michaelmccamy/Notechalant/app/src/motion/README.md

# Motion

Owner is CpE 2. This folder turns raw gyro samples into cursor movement.

## The contract

`index.js` must export `createMotion(config)`, which returns an object with

- `update(sample)` takes one sample (format in `docs/data-format.md`) and returns `{ dx, dy, ready }`
  - `dx`, `dy` are how far to move the cursor, in screen pixels, for this sample
  - `ready` is `false` while calibrating, and the app ignores movement until it's `true`
- `reset()` starts over, including calibration. The app calls it when the user presses **R**.
- `config` is the live settings object, so a tuning slider can change values on the fly.

Everything else in this folder is yours. Split it into as many files as you want.

## Suggested order

1. **Bias calibration.** Average the gyro for the first 2 seconds while the pen is still, subtract that from every sample after. Return `ready: false` until it's done.
2. **Axis mapping.** `xVector` and `yVector` are the gyro directions (gx, gy, gz) that move the cursor right and down. They're vectors, not single axes, because the sensor sits at an angle in the pen, so a sideways sweep turns all three axes. The defaults were measured on the real pen. To measure again for a different grip, press **D** and run the **Axis wizard**: hold still, draw a line right, draw a line down, 2 seconds each, the way you write. **D** also shows live gyro graphs and records debug files (see `docs/data-format.md`).
3. **One Euro filter** on `dx` and `dy` (or on the gyro rates) so slow movement is smooth and fast movement stays responsive.
4. **Dead zone** so tiny hand tremor while holding still doesn't move the cursor.
5. **Tuning** on the live pen. Sensitivity and filter settings are the knobs.

## Testing without the pen

Load `data/recordings/synthetic/shapes.jsonl` in the app. It traces a circle, a square, and a check mark, with a small gyro bias and noise built in. With the placeholder you'll see the shapes drift and wobble. Once calibration and filtering work, they should come out clean.

The generator in `tools/make-synthetic.mjs` documents the exact bias and noise it adds.
