michaelmccamy/Notechalant/firmware/esp32/secrets.example.h

// Copy this file to secrets.h and fill it in. secrets.h is gitignored.

// 2.4 GHz network the laptop is also on. Leave WIFI_SSID empty for Bluetooth and USB only.
#define WIFI_SSID "your-network"
#define WIFI_PASSWORD "your-password"

// The laptop's address on that network, from the relay's startup output
// (the en0 line on a Mac). Just the IP, no ws:// and no port.
#define RELAY_HOST "192.168.1.23"
