michaelmccamy/Notechalant/(commit log)

2026-10-17 Define the pen data format and add a synthetic recording
    One JSON sample per line at about 100 Hz. The synthetic recording has known shapes so the app can be tested with no hardware.
2026-10-17 Add firmware folders for the STM32 test and ESP32 pen
    Both boards must print samples in the format from docs/data-format.md.
2026-10-17 Add the ink canvas app with a shared input hub
    USB serial, WiFi WebSocket, and recording replay all feed one onPenData function. Includes a placeholder motion module and tests for the sample parser and motion math.
2026-10-17 Add the WiFi relay and a fake pen for testing
    The ESP32 now connects as a WebSocket client to a relay on the laptop
    (port 8080) instead of hosting its own network. That keeps the laptop
    online so the recognition server can still reach Gemini. Direct WiFi
    stays documented as the fallback.
    The relay lists every IPv4 interface on startup, with en0 marked as the
    likely WiFi, since the first address can be a VPN.
2026-10-17 Add the Relay input to the app
    A Relay button connects to ws://localhost:8080/app, reconnects every
    second if the relay restarts, and shows relay and pen status with the
    live sample rate. Samples go through the existing parseSample and
    hub.onPenData, so motion processing is unchanged. Mouse input and the
    USB, WiFi and recording sources work as before.
2026-10-17 Add the ESP32 pen firmware
    Reads the MPU6050 over Wire registers at 100 Hz on a micros() schedule
    and sends each sample as one JSON line (docs/data-format.md) to the
    relay over WiFi and to USB serial as a fallback. Networking runs in its
    own task on core 0 so a slow or missing relay never stalls sampling.
    WiFi, relay host and password live in a gitignored secrets.h.
    Builds for the XIAO ESP32S3 with no warnings.
    [esp32.ino, secrets.example.h]
2026-10-17 Deploy the app and recognition to Vercel
    vercel.json builds app/ and serves api/recognize.mjs as a function. The Gemini call moved to server/recognize.mjs so the local server and the Vercel function share it. The relay still runs on the laptop.
2026-10-17 Switch recognition to Gemini Flash-Lite and retry stalled requests
    Flash took 4 to 40 seconds and the free tier allows only 5 requests per minute. Flash-Lite answered in about 1 second and read every test image correctly. Requests that stall for 8 seconds are retried once. A blank canvas now returns (nothing recognized) instead of a sentence.
2026-10-17 Open Word, Excel, and PowerPoint files, and single files without a folder
    Word files render with docx-preview, spreadsheets with read-excel-file, and slides with pptx-renderer, all in the browser and each loaded only when first needed. Word and Excel content is laid out once and split into pages between paragraphs and rows, so no line is cut, and spreadsheet pages repeat the heading row. Open File and drag and drop open files on their own, with their ink saved in the browser. Dropping a folder opens it in the explorer.
2026-10-17 Add Bluetooth Low Energy as the main wireless path
    The pen advertises as "Notechalant Pen" and notifies packed binary
    samples: 17 bytes each, t as uint32, the six IMU readings as raw int16
    counts, pen as uint8. It sends one notification every 20 ms, as many
    samples as the negotiated MTU fits (it asks for 247, up to 14 samples).
    USB JSON output is unchanged. WiFi is now optional: with WIFI_SSID
    empty the WiFi task never starts and the stack is left out of the
    build (662 KB instead of 1.29 MB). Advertising restarts after a
    disconnect, and the LED blinks while waiting and is solid when
    connected over Bluetooth or to the relay.
    The app gets a Bluetooth button using Web Bluetooth, filtered by th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
2026-10-17 Restyle the app to design C (Field Notes)
    Three full-height columns: a sidebar with the brand, explorer, and a pen connection card; the editor with its own toolbar, pill tabs, and a footer that now holds the status line; and the notes panel. Figtree and Bricolage Grotesque, a green-grey palette, and notebook paper on the whiteboard only, drawn in CSS so saved copies and transcription never see it. Buttons keep their icons when their labels change, connection buttons show which one is on by fill and aria-pressed, and swatches are named. Every element id is unchanged. The toolbar compacts in measured steps so it stays on one line from 980px windows up.
2026-10-17 Calibrate, smooth, and map the pen motion from real data
    The motion module was still the placeholder: no bias removal, no
    filtering, one gyro axis per screen direction. It now:
    - averages the gyro for the first 2 s after a reset and subtracts that
    bias, returning ready: false meanwhile
    - maps rotation to the screen with direction vectors instead of single
    axes. A recording of left, right, up, and down sweeps on the real pen
    showed the sensor sits at an angle, so every sweep turned all three
    axes and the old gz/gy mapping drew them 11 to 39 degrees off. The
    measured defaults keep them within 8 degrees.
    - adds a One Euro filter (smoothing 0 to 1, off by default) and a
    deadzone tha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
2026-10-17 Add a motion debug panel with live graphs, axis wizard, and recording
    Press D (or T) for one floating panel that works with every input, since
    it wraps the motion module the input hub calls. Inputs and the sample
    format are unchanged.
    - Live view: scrolling gx/gy/gz and dx/dy graphs for the last 5 s with
    pen-down spans shaded, pen state, sample rate, bias with Recalibrate,
    and a faint cursor trail over the page that shows with the pen up too.
    The trail is its own canvas, so it never reaches the ink, saved
    copies, or transcription.
    - Axis wizard: runs the motion module's hold still, tilt right, tilt up
    steps with a progress bar, then shows the dominant axis and sign it
    found for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
2026-10-17 Replace the pen button with a capacitive touch pad on D1
    The pen is down while a finger is on a bare metal pad wired to D1
    (GPIO 2, touch channel 2), with no resistor and no ground. At startup
    the firmware averages the untouched reading for 1 s. The pen then goes
    down once touchRead is 80% above that baseline and up again below 50%,
    followed by the existing 20 ms debounce. A status line every second
    shows the live reading and its distance from the baseline.
    Thresholds come from tests on the pen: a finger on bare metal added 93
    to 380%, while the untouched reading drifted from -15% to +35% (it
    stays raised after a touch, and a nearby hand raises it). Through the
    plastic of a jumper wire a to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
    [esp32.ino]
2026-10-17 Show unrecognized remote lines in the status bar
    Boot text and unmapped buttons ("OTHER" with their code) now show as "Remote sent: ..." and log to the console, so it's clear whether the UNO is getting through.
2026-10-18 Add tutor mode that checks notes and answers questions
    With Tutor on, each new transcription goes to Gemini for a review: grammar, spelling, math steps, and facts. Problems show under the note as wrong and fixed text with a reason and an Apply fix button. Unfinished problems get a question about what help is wanted, with quick replies, and any note can be asked about. Feedback and conversations save with the notes. The Gemini call is now shared by recognition and the tutor.
2026-10-18 Compensate for pen roll, and calibrate only while the pen is still
    Tested on tonight's debug recordings from the breadboard pen.
    Calibration accepted any 2 s window, so recalibrating while moving
    saved biases up to 18 deg/s and the cursor drifted, which slanted down
    strokes. Now each axis must stay within 2.5 deg/s standard deviation
    (a still pen measures about 0.4, a hand-held one 0.8), or the window
    starts over and the panel says to hold still.
    Fixed axis vectors only hold for the grip they were measured with:
    rolling the pen in the hand mixed up and down with sideways. Roll
    compensation, now the default, tracks "up" from the accelerometer.
    Left and right is turning around up, and up and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
2026-10-18 Add tonight's debug recordings from the breadboard pen
    Seven recordings from tuning: sweeps, HI attempts, and the axis wizard,
    some drawn with Space. Used to find the calibration and roll problems.
2026-10-18 Add laser pointer mode and a hold-still card while calibrating
    Writing by rotation rate felt unintuitive, so the cursor now goes where
    the pen points, with the old relative mode behind a D panel checkbox.
    - Gravity is a complementary filter: the gyro turns the estimate as the
    pen turns and the accelerometer pulls it back over 0.8 s. Roll
    compensation in relative mode uses it too.
    - Pitch is the pen axis against gravity, yaw the gyro integrated around
    gravity, so neither depends on how the pen is rolled. Plus or minus
    20 degrees across and 12 up and down fill the page (sliders in D).
    - A One Euro filter on the angles (pointer smoothing 0.5, beta 0.3)
    steadies the cursor without lag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
2026-10-18 Add a four-slide demo PDF for Circle to ask and the pitch
    data/samples/demo-slides.pdf, built by tools/make-demo-slides.mjs:
    a title slide, two math problems (x² - 5x + 6 = 0 and d/dx (3x² + 2x)),
    a study hours vs exam score bar chart, and a dense Big O paragraph.
    Large type and space around each item, so it's easy to circle from
    across a room.
    Built with pdf-lib from app/ instead of matplotlib and reportlab, which
    aren't installed here, and the chart is vector shapes so it stays sharp.
2026-10-18 Let the tutor see drawings and the page being read
    The tutor now gets a picture of the new ink and a picture of the page on screen with the ink drawn on it, plus the page's text for PDFs and text files. Drawings with no words get their own note and a review, so wrong diagrams and graphs are caught. Circling something on the page and writing a question mark gets an explanation, and a box under the notes asks the tutor about the current page.
2026-10-18 Add Circle to ask: circle part of the page to get it explained
    With the new Ask toggle on, drawing a loop around part of the page:
    - captures what's inside it, document and ink, the way Save copy
    renders pages (html-to-image), cropped to the loop's box
    - sends it to a new POST /api/explain (server/index.mjs, plus
    api/explain.mjs on Vercel), separate from transcribe, which asks
    Gemini to explain it briefly for a student and solve math step by
    step, starting with a short "About:" line
    - shows the answer in a large card next to the circle, with math in
    KaTeX. A tap on the pad (or a click), Esc, or x closes it, and the
    tap's dot is removed
    - adds "### About" plus the answer to the no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
2026-10-18 Add screen corner calibration for pointer mode
    Point at the page's four corners in turn and tap the pad (or press
    Enter), and the cursor then goes exactly where the pen points, instead
    of a fixed 20 by 12 degree range around the middle.
    Pointing angles become flat-plane coordinates (gnomonic), where a flat
    screen seen from where you stand is a perspective view, so a homography
    through the four corners maps every direction to the spot it hits,
    whatever the distance, offset, or viewing angle (motion/screenMap.js).
    Tested with a screen off to the side, above, and turned 30 degrees.
    - Each corner is the pointing from 0.1 s before the tap, so pressing
    the pad doesn't nudge it. Nothing moves o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
2026-10-18 Learn the pen direction during corner calibration, and keep debug out of present mode
    After the sensor moved on the breadboard, down strokes slanted again:
    the pen direction and left-right sign the app had were measured with
    the old mount. Corner calibration already has the user move right (top
    left to top right) and down (top right to bottom right), the same
    motions the axis wizard measures, so it now learns both from them, with
    gravity from halfway down the right edge where the pen is about level.
    Starting from the wrong direction and sign, one calibration recovers
    them in the tests, and a straight down move stays straight.
    Present mode also hides the debug panel and cursor trail, so noth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
2026-10-18 Writing mode: keep letter shapes, and stop the cursor sliding after a letter
    From a recording of "then" (data/recordings/debug/debug-2026-10-17T23-24-41.jsonl):
    - The precision curve gave full gain only at 25 deg/s, but writing on the
    pen is 11 to 27 deg/s, so it shrank slow parts of letters more than fast
    ones. The e's loop came out squashed and a slow down stroke became an
    8 px slanted tick. Full gain now starts at 6 deg/s on a smoothed speed,
    never below 0.3 of it, with writingGain 0.6.
    - The lazy brush string defaults to 4 px, so it doesn't cut across loops.
    - After lifting, the cursor no longer glides back on a timer. The offset
    shrinks only as the pen turns, so it catches up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
2026-10-18 Add setup links: ?setup=writing-test switches on the writing test settings
2026-10-18 Add an ink eraser and a Clear button for notes
    The eraser (toolbar button or E) removes whole strokes the cursor
    passes over while the pen is down, which is forgiving when the air pen
    wobbles. One pass is one undo step. Picking a color, on screen or with
    the remote, goes back to writing.
    Notes track ink by stroke position, so the canvas reports erased and
    restored strokes and the notes shift their transcribed count and block
    strokes to match. New writing after an erase still gets transcribed,
    and old writing isn't sent again.
    The notes panel gets a Clear button that deletes every note for the
    open file after a second click. It keeps what was transcribed, so the
    ink still on the page isn't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
2026-10-18 Straighten slanted writing: K ends with a line across and a line down when Write is on
    Writing at a desk (data/recordings/debug/debug-2026-10-17T23-45-45.jsonl),
    down strokes leaned 28 degrees and lines across rose 10, even after corner
    calibration: writing turns the hand differently from pointing. With Write
    on, corner calibration now asks for one line across and one line down, and
    learns a 2 x 2 correction (writingCorrection) that makes them exactly level
    and upright. Replayed on the recording, down lines went from 119 to 91
    degrees and lines across from -10 to 0. Lines more than 45 degrees off are
    refused, a tap asks again, and Esc skips the step and keeps the corners.
    Also keeps the poi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
2026-10-18 Refuse corner calibrations that would make the pen far too sensitive
    A desk calibration (data/recordings/debug/debug-2026-10-17T23-56-50.jsonl)
    came out 21.5 degrees across but 3.7 tall: the near and far corners were
    reached by moving the hand, which the gyro can't feel. Up and down was then
    about 200 px per degree and writing was unusable. Corners now need at least
    8 by 6 degrees (both sides averaged) and no more than 4 times wider than
    tall, and the guide says to keep the hand in place and tilt the pen.
2026-10-18 Write mode works like a mouse: the hand stays put, a flick resets the wrist
    Writing in pointer mode meant twisting the wrist further along each line,
    which changed how the hand wrote and the slant as it went (debug recording
    00-01-38). With Write on, the ink now moves by how much the pen turns,
    converted with the corner calibration's scale at the page middle, not to
    where it points:
    - slow moves with the pen up carry on to the next letter or line,
    - a quick move with the pen up (over 30 deg/s) doesn't move the cursor,
    like lifting a mouse, so the wrist can reset,
    - a double tap puts the cursor where the pen points.
    The writing step of K is now one line down, and only its lean is
    corrected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
2026-10-18 Remove the writing slant step from K: its line never matched the writing
    In debug recording 00-14-41 the calibration line down leaned 20 degrees
    left while real down strokes leaned 4 to 5, so the correction pushed every
    down stroke 35 to 55 degrees to the right. The line is drawn right after
    tapping the last corner, with the hand still twisted towards it. Writing
    like a mouse keeps the hand in one place, and down strokes come out nearly
    upright without any correction. K is the four corners again, and a saved
    correction is dropped on load.
2026-10-18 Simplify the toolbar and sidebar for the demo
    - Snap and auto transcribe are always on. Their toggles and the
    Transcribe button are gone. Enter still transcribes now.
    - The sidebar's pen section is one Connect pen button (Bluetooth) and
    Calibrate screen. Relay, USB, WiFi, Remote, and Load recording moved
    to the D panel, where they work as before.
    - The small File and Folder buttons hide while the big Open buttons show.
    - Ask on makes the pen aim like a laser pointer, for circling from across
    the room. Ask off is writing mode, like a mouse.
2026-10-18 Put the Remote button back in the sidebar, under Connect pen
2026-10-18 Label the sidebar's connection buttons Connect devices
2026-10-18 Toolbar: Clean up also snaps shapes, Auto is back, clearer device buttons
    - Clean up is one switch: on, lines and shapes snap clean when the pen
    lifts and handwriting turns into typed text after a pause; off,
    everything stays as drawn. Snap no longer has its own setting.
    - The Auto switch is back: off, writing is typed up only on Enter.
    - Clean up and Auto are plain switches like Ask. They sat in the old
    Transcribe button's green box, and switched-on switches showed white on
    white; now they're green.
    - The sidebar says Connect pen / Disconnect pen and Connect remote /
    Disconnect remote. The "Pen: online" line is gone.
2026-10-18 Add writing size setup: write hello once, and the writing gain is set to match
    Set writing size (sidebar, or W) shows a card asking for "hello" at a
    comfortable size. After a 1.5 s pause (or Enter), the word's height sets
    writingGain so it comes out 64 px tall, about two ruled lines, kept
    between 0.2 and 1.2. The sample is undone, and nothing is transcribed,
    snapped, or cleaned up meanwhile. Esc cancels. The new gain is saved like
    the D panel's slider.
2026-10-18 Remove the writing size setup
    This reverts commit 3324708. The Set writing size button, its card, and
    the W shortcut are gone. Writing gain is still in the D panel.
2026-10-18 Map remote buttons 1-7 to clean up, ask, tutor, calibrate, and auto
    1, 2, 3 and 7 flip the Clean up, Ask, Tutor and Auto switches. 4 and 5
    pick the first or second quick answer on the newest tutor question.
    6 starts screen calibration, and while calibrating it marks each corner.
    [remote.ino]
2026-10-18 Rewrite the README around what the demo shows
    What Notechalant does, the demo in four steps, the hardware, connecting
    and calibrating the pen, controls and gestures, how it works, and the
    repo layout. The relay, USB, WiFi, and recording inputs move to a short
    development section, since the demo uses Bluetooth only.
2026-10-18 README: the remote's buttons 1 to 7
2026-10-18 Remove triple tap to clear the page
    This reverts commit 0ca3844, and takes it out of the README. A double
    tap recenters as before. Clearing is the Clear button.
2026-10-18 README: list every button, in the toolbar, sidebar, notes, and remote
2026-10-18 Drop the "You asked" section from tutor notes
    The question already shows in the tutor's thread, so it was repeated.
    For circle and underline asks, the stock prompt is hidden too and only
    the tutor's answer shows.
2026-10-18 Remote: drop a second copy of the same button within 300 ms
    Some presses decoded twice, so toggles flipped on and straight back off.
    [remote.ino]
2026-10-18 Keep re-measuring the gyro bias while the pen is held still
    The bias drifts as the sensor warms up. 12 minutes after calibrating, a
    pen held still read about 1 deg/s (debug recording 00-27-08), so the
    cursor crept about 20 px a second while writing and drawing got harder
    the longer a session went. Now every second the pen is held still with
    the pad up (every axis within 1.5 deg/s, the reading within 2.5 deg/s of
    the bias) the bias moves 30% of the way to the reading. A slow steady
    turn, shaky movement, and writing are left alone. Replayed on the
    recording, it learned the drift (0.9, 0.4, -0.4 deg/s) at the first
    pause. biasTracking: false turns it off.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
2026-10-18 Double tap recalibrates, triple tap clears the page
    A double tap on the pad now re-measures the gyro (hold still a moment),
    then the cursor starts from where the pen points, for when it drifts.
    Triple tap clearing the page is back (undoing fc6f952). Neither is in
    the README.
